Leelin-441/stc51-temp-fan/docs/07-测试报告-自动生成.md

# 重复测试报告（由 tools/sim_controller.py 自动生成）

> 本报告由脚本自动生成，请勿手工修改；重跑 `python tools/sim_controller.py` 即可刷新。

## 一、测试方法

固件的判定逻辑（阶梯回差、报警锁存、故障保护、模式优先级）在 PC 上用 Python **逐行等价复现**，全部阈值直接解析自 `firmware/config.h`，不存在仿真与固件参数不一致的可能。

每个用例重复 **3 轮 × 5 次 = 15 次**，逐条记录见 `docs/06-测试记录-自动生成.csv`。

## 二、用例结果汇总

| 编号 | 测试项 | 通过/总数 | 结果 |
|---|---|---|---|
| R1-01 | 停机态：温度低于 Tset-2.0℃ | 15/15 | ✅ 通过 |
| R1-02 | 低速档：温度进入 Tset-2.0 ~ Tset | 15/15 | ✅ 通过 |
| R1-03 | 中速档：温度进入 Tset ~ Tset+3.0 | 15/15 | ✅ 通过 |
| R1-04 | 全速档：温度 ≥ Tset+3.0 | 15/15 | ✅ 通过 |
| R1-05 | 报警：温度 ≥ Tset+8.0，强制全速 | 15/15 | ✅ 通过 |
| R2-01 | 手动模式：指定 3 档，忽略传感器 | 15/15 | ✅ 通过 |
| R2-02 | 手动模式：指定 0 档，即使温度很高（未报警）也不转 | 15/15 | ✅ 通过 |
| R3-01 | 回差上沿：Tset-2.5℃ 仍为停机 | 15/15 | ✅ 通过 |
| R3-02 | 回差保持：先进中速，再降到 Tset-0.5℃ 仍保持 | 15/15 | ✅ 通过 |
| R3-03 | 回差退出：降到 Tset-2.5℃ 回落到低速 | 15/15 | ✅ 通过 |
| R4-01 | 在线改目标温度：Tset=25.0 时 25.0℃ 进中速 | 15/15 | ✅ 通过 |
| R4-02 | 报警最短保持 5s：降回安全区后 2s 内仍报警 | 15/15 | ✅ 通过 |
| R5-01 | 传感器故障保护：连续 3 次读失败 → 电机强制停 | 15/15 | ✅ 通过 |
| R6-01 | RESET 后目标温度回到默认值 | 15/15 | ✅ 通过 |
| R7-01 | 低温边界：-5.5℃ 仍为停机 | 15/15 | ✅ 通过 |
| R7-02 | 高温边界：125.0℃ 报警 | 15/15 | ✅ 通过 |
| R7-03 | 目标温度限幅：设成 90.0℃ 应被夹到 60.0℃ | 15/15 | ✅ 通过 |
| R7-04 | 目标温度限幅：设成 5.0℃ 应被夹到 20.0℃ | 15/15 | ✅ 通过 |

**合计：270/270 次符合预期，符合率 100.0%**

## 三、阶梯回差专项验证

### 3.1 阈值抖动测试

把温度在「进低速」阈值上下反复抖动 100 次（33.1℃ / 32.9℃ 交替，模拟传感器噪声）：

| 方案 | 档位切换次数 |
|---|---|
| **本设计（阶梯回差）** | **1 次** |
| 对照：无回差（进档退档同一阈值） | 100 次 |

结论：回差把档位切换从 100 次降到 **1 次**，减少了 99% 的无效动作。

### 3.2 温度缓慢变化测试

温度从 20.0℃ 缓升到 60.0℃ 再降回 20.0℃（步进 0.1℃），档位切换点：

| 温度(℃) | 切到档位 |
|---|---|
| 33.0 | LOW |
| 35.0 | MID |
| 38.0 | HIGH |
| 36.0 | MID |
| 33.0 | LOW |
| 31.0 | STOP |

全程切换 **6 次**（理论上行 3 次 + 下行 3 次 = 6 次）。

## 四、随机模糊测试

随机生成 5000 组输入（温度 -55.0~125.0℃、随机切换运行模式与手动档位、随机改目标温度），检查 6 条设计不变式：

1. 报警状态下占空比必须为 100%
2. 传感器故障状态下占空比必须为 0（电机强制停转）
3. 手动模式的档位必须等于手动设定值
4. 档位只能在 0~3 之间
5. 占空比必须与档位表一致
6. 温度达到报警阈值必须立即报警

✅ **5000 组随机输入全部满足上述 6 条不变式，0 处违规。**

## 五、结论

1. 预设用例重复 270 次，**270 次全部符合预期**，符合率 100.0%。
2. 阶梯回差把临界抖动时的档位切换从 100 次降到 1 次，消除了电机反复启停。
3. 温度缓变全程只切换 6 次，与理论值 6 次一致。
4. 5000 组随机输入下 6 条设计不变式**零违规**。

**结论：控制逻辑在可重复测试下表现与设计预期完全一致。**

---

> 说明：本报告验证的是**判定逻辑**。硬件层面（DS18B20 时序、PWM 波形、数码管扫描、电机实际转速）的验证方法见 `docs/05-测试方案与判定标准.md`，需要在实物上复测并手工记录。
