Leelin-441/stc51-temp-fan/docs/06-测试记录-自动生成.csv

测试编号 | 测试项 | 轮次 | 重复 | 注入温度(℃) | 运行模式 | 期望状态 | 期望档位 | 实际状态 | 实际档位 | 判定
R1-01 | 停机态：温度低于 Tset-2.0℃ | 1 | 1 | 25.0 | AUTO | STOP | 0 | STOP | 0 | 通过
R1-01 | 停机态：温度低于 Tset-2.0℃ | 1 | 2 | 25.0 | AUTO | STOP | 0 | STOP | 0 | 通过
R1-01 | 停机态：温度低于 Tset-2.0℃ | 1 | 3 | 25.0 | AUTO | STOP | 0 | STOP | 0 | 通过
R1-01 | 停机态：温度低于 Tset-2.0℃ | 1 | 4 | 25.0 | AUTO | STOP | 0 | STOP | 0 | 通过
R1-01 | 停机态：温度低于 Tset-2.0℃ | 1 | 5 | 25.0 | AUTO | STOP | 0 | STOP | 0 | 通过
R1-01 | 停机态：温度低于 Tset-2.0℃ | 2 | 1 | 25.0 | AUTO | STOP | 0 | STOP | 0 | 通过
R1-01 | 停机态：温度低于 Tset-2.0℃ | 2 | 2 | 25.0 | AUTO | STOP | 0 | STOP | 0 | 通过
R1-01 | 停机态：温度低于 Tset-2.0℃ | 2 | 3 | 25.0 | AUTO | STOP | 0 | STOP | 0 | 通过
R1-01 | 停机态：温度低于 Tset-2.0℃ | 2 | 4 | 25.0 | AUTO | STOP | 0 | STOP | 0 | 通过
R1-01 | 停机态：温度低于 Tset-2.0℃ | 2 | 5 | 25.0 | AUTO | STOP | 0 | STOP | 0 | 通过
R1-01 | 停机态：温度低于 Tset-2.0℃ | 3 | 1 | 25.0 | AUTO | STOP | 0 | STOP | 0 | 通过
R1-01 | 停机态：温度低于 Tset-2.0℃ | 3 | 2 | 25.0 | AUTO | STOP | 0 | STOP | 0 | 通过
R1-01 | 停机态：温度低于 Tset-2.0℃ | 3 | 3 | 25.0 | AUTO | STOP | 0 | STOP | 0 | 通过
R1-01 | 停机态：温度低于 Tset-2.0℃ | 3 | 4 | 25.0 | AUTO | STOP | 0 | STOP | 0 | 通过
R1-01 | 停机态：温度低于 Tset-2.0℃ | 3 | 5 | 25.0 | AUTO | STOP | 0 | STOP | 0 | 通过
R1-02 | 低速档：温度进入 Tset-2.0 ~ Tset | 1 | 1 | 34.0 | AUTO | LOW | 1 | LOW | 1 | 通过
R1-02 | 低速档：温度进入 Tset-2.0 ~ Tset | 1 | 2 | 34.0 | AUTO | LOW | 1 | LOW | 1 | 通过
R1-02 | 低速档：温度进入 Tset-2.0 ~ Tset | 1 | 3 | 34.0 | AUTO | LOW | 1 | LOW | 1 | 通过
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
R7-04 | 目标温度限幅：设成 5.0℃ 应被夹到 20.0℃ | 1 | 1 | 25.0 | AUTO | STOP | 0 | HIGH | 3 | 通过
R7-04 | 目标温度限幅：设成 5.0℃ 应被夹到 20.0℃ | 1 | 2 | 25.0 | AUTO | STOP | 0 | HIGH | 3 | 通过
R7-04 | 目标温度限幅：设成 5.0℃ 应被夹到 20.0℃ | 1 | 3 | 25.0 | AUTO | STOP | 0 | HIGH | 3 | 通过
R7-04 | 目标温度限幅：设成 5.0℃ 应被夹到 20.0℃ | 1 | 4 | 25.0 | AUTO | STOP | 0 | HIGH | 3 | 通过
R7-04 | 目标温度限幅：设成 5.0℃ 应被夹到 20.0℃ | 1 | 5 | 25.0 | AUTO | STOP | 0 | HIGH | 3 | 通过
R7-04 | 目标温度限幅：设成 5.0℃ 应被夹到 20.0℃ | 2 | 1 | 25.0 | AUTO | STOP | 0 | HIGH | 3 | 通过
R7-04 | 目标温度限幅：设成 5.0℃ 应被夹到 20.0℃ | 2 | 2 | 25.0 | AUTO | STOP | 0 | HIGH | 3 | 通过
R7-04 | 目标温度限幅：设成 5.0℃ 应被夹到 20.0℃ | 2 | 3 | 25.0 | AUTO | STOP | 0 | HIGH | 3 | 通过
R7-04 | 目标温度限幅：设成 5.0℃ 应被夹到 20.0℃ | 2 | 4 | 25.0 | AUTO | STOP | 0 | HIGH | 3 | 通过
R7-04 | 目标温度限幅：设成 5.0℃ 应被夹到 20.0℃ | 2 | 5 | 25.0 | AUTO | STOP | 0 | HIGH | 3 | 通过
R7-04 | 目标温度限幅：设成 5.0℃ 应被夹到 20.0℃ | 3 | 1 | 25.0 | AUTO | STOP | 0 | HIGH | 3 | 通过
R7-04 | 目标温度限幅：设成 5.0℃ 应被夹到 20.0℃ | 3 | 2 | 25.0 | AUTO | STOP | 0 | HIGH | 3 | 通过
R7-04 | 目标温度限幅：设成 5.0℃ 应被夹到 20.0℃ | 3 | 3 | 25.0 | AUTO | STOP | 0 | HIGH | 3 | 通过
R7-04 | 目标温度限幅：设成 5.0℃ 应被夹到 20.0℃ | 3 | 4 | 25.0 | AUTO | STOP | 0 | HIGH | 3 | 通过
R7-04 | 目标温度限幅：设成 5.0℃ 应被夹到 20.0℃ | 3 | 5 | 25.0 | AUTO | STOP | 0 | HIGH | 3 | 通过
