Leelin-441/stc51-temp-fan/firmware/lcd1602.h

/******************************************************************************
 * @file    lcd1602.h
 * @brief   LCD1602 字符液晶驱动（8 位数据模式，只写不读）。
 *
 *  ★ 引脚固定跟着**普中 PZ-51 实验板**的 LCD 专用插座走（见 config.h）：
 *
 *      LCD1602 引脚        接到
 *      ------------------------------------------
 *      VSS (1)            GND
 *      VDD (2)            +5V
 *      V0  (3)            10kΩ 电位器中间脚 ← 对比度，不接好是空白/黑方块
 *      RS  (4)            P2.6
 *      RW  (5)            P2.5（软件固定拉低，只写不读）
 *      E   (6)            P2.7
 *      D0~D7 (7~14)       P0.0 ~ P0.7
 *      A   (15)           +5V（背光）
 *      K   (16)           GND
 *
 *  这块板的 LCD 插在**出厂焊死的专用插座**上，接线印在板子上、不能自己改，
 *  所以驱动必须适配它。早期版本按"自己接线"设计成 P1.1~P1.4 + P1.6 + P1.7，
 *  插到插座上完全对不上，现象就是**屏幕只有一排黑方块**。
 *
 *  ★ 关于 P0
 *    P0 在普中板上同时接到数码管的 74HC245，写 LCD 时数码管会跟着乱显示，
 *    属正常现象 —— 拔掉数码管模块的电源跳线帽即可，不影响 LCD。
 *    P0 是**整口写**（`P0 = dat;`），没有其它功能共用这 8 根线。
 *
 *  ★ 关于 P2.5 / P2.6 / P2.7
 *    用 sbit 逐位写，不会碰到 P2.0/P2.1（LED）和 P2.2~P2.4（数码管位选）。
 ******************************************************************************/

#ifndef __LCD1602_H__
#define __LCD1602_H__

#include "config.h"

void lcd_init(void);

/** @brief 发一条命令。 */
void lcd_cmd(u8 cmd);

/** @brief 发一个字符。 */
void lcd_char(char c);

/** @brief 发一串 ROM 里的字符串常量。 */
void lcd_str(char code *s);

/** @brief 光标定位。row: 0=第一行，1=第二行；col: 0~15。 */
void lcd_goto(u8 row, u8 col);

/** @brief 清屏（内部会等 2ms，不要在频繁刷新的路径里调用它）。 */
void lcd_clear(void);

/** @brief 当前光标列（0~15）。 */
u8   lcd_col(void);

/** @brief 用空格补到指定列，不足则不动。 */
void lcd_pad(u8 to_col);

/** @brief 输出定点温度，固定占 5 列，如 " 35.5"、"-12.3"、"105.5"。 */
void lcd_temp1(s16 t_x10);

/** @brief 输出无符号数，固定占 width 列，右对齐前补空格。 */
void lcd_ufixed(u16 v, u8 width);

#endif /* __LCD1602_H__ */
